DL7AD/seatel/hardware/v1.1/driver.kicad_sch

## KiCad design hardware/v1.1/driver.kicad_sch (2024-06-26)

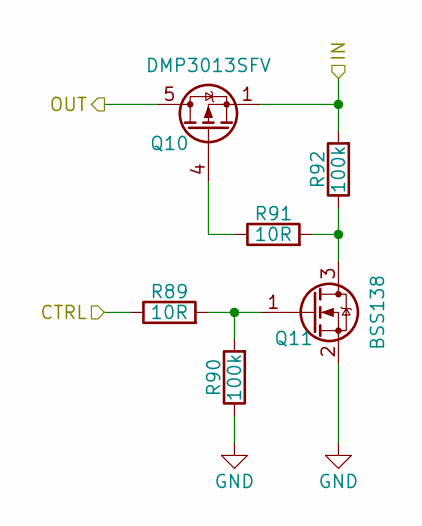
[picture p2: schematic driver.kicad_sch]

Parts:
Q10: DMP3013SFV; Diodes_PowerDI3333-8
Q11: BSS138; SOT-23
R89, R91: 10R; R_0603_1608Metric
R90, R92: 100k; R_0603_1608Metric

Connections:
CTRL: R89.1
GND: Q11.2 (S), R90.1
IN: Q10.1 (S), Q10.2 (S), Q10.3 (S), R92.2
unnamed: Q10.4 (G), R91.1
unnamed: Q11.1 (G), R89.2, R90.2
unnamed: Q11.3 (D), R91.2, R92.1
OUT: Q10.5 (D)
