DL7AD/seatel/hardware/v1.1/seatel.kicad_sch

## KiCad design hardware/v1.1/seatel.kicad_sch (2024-06-26)

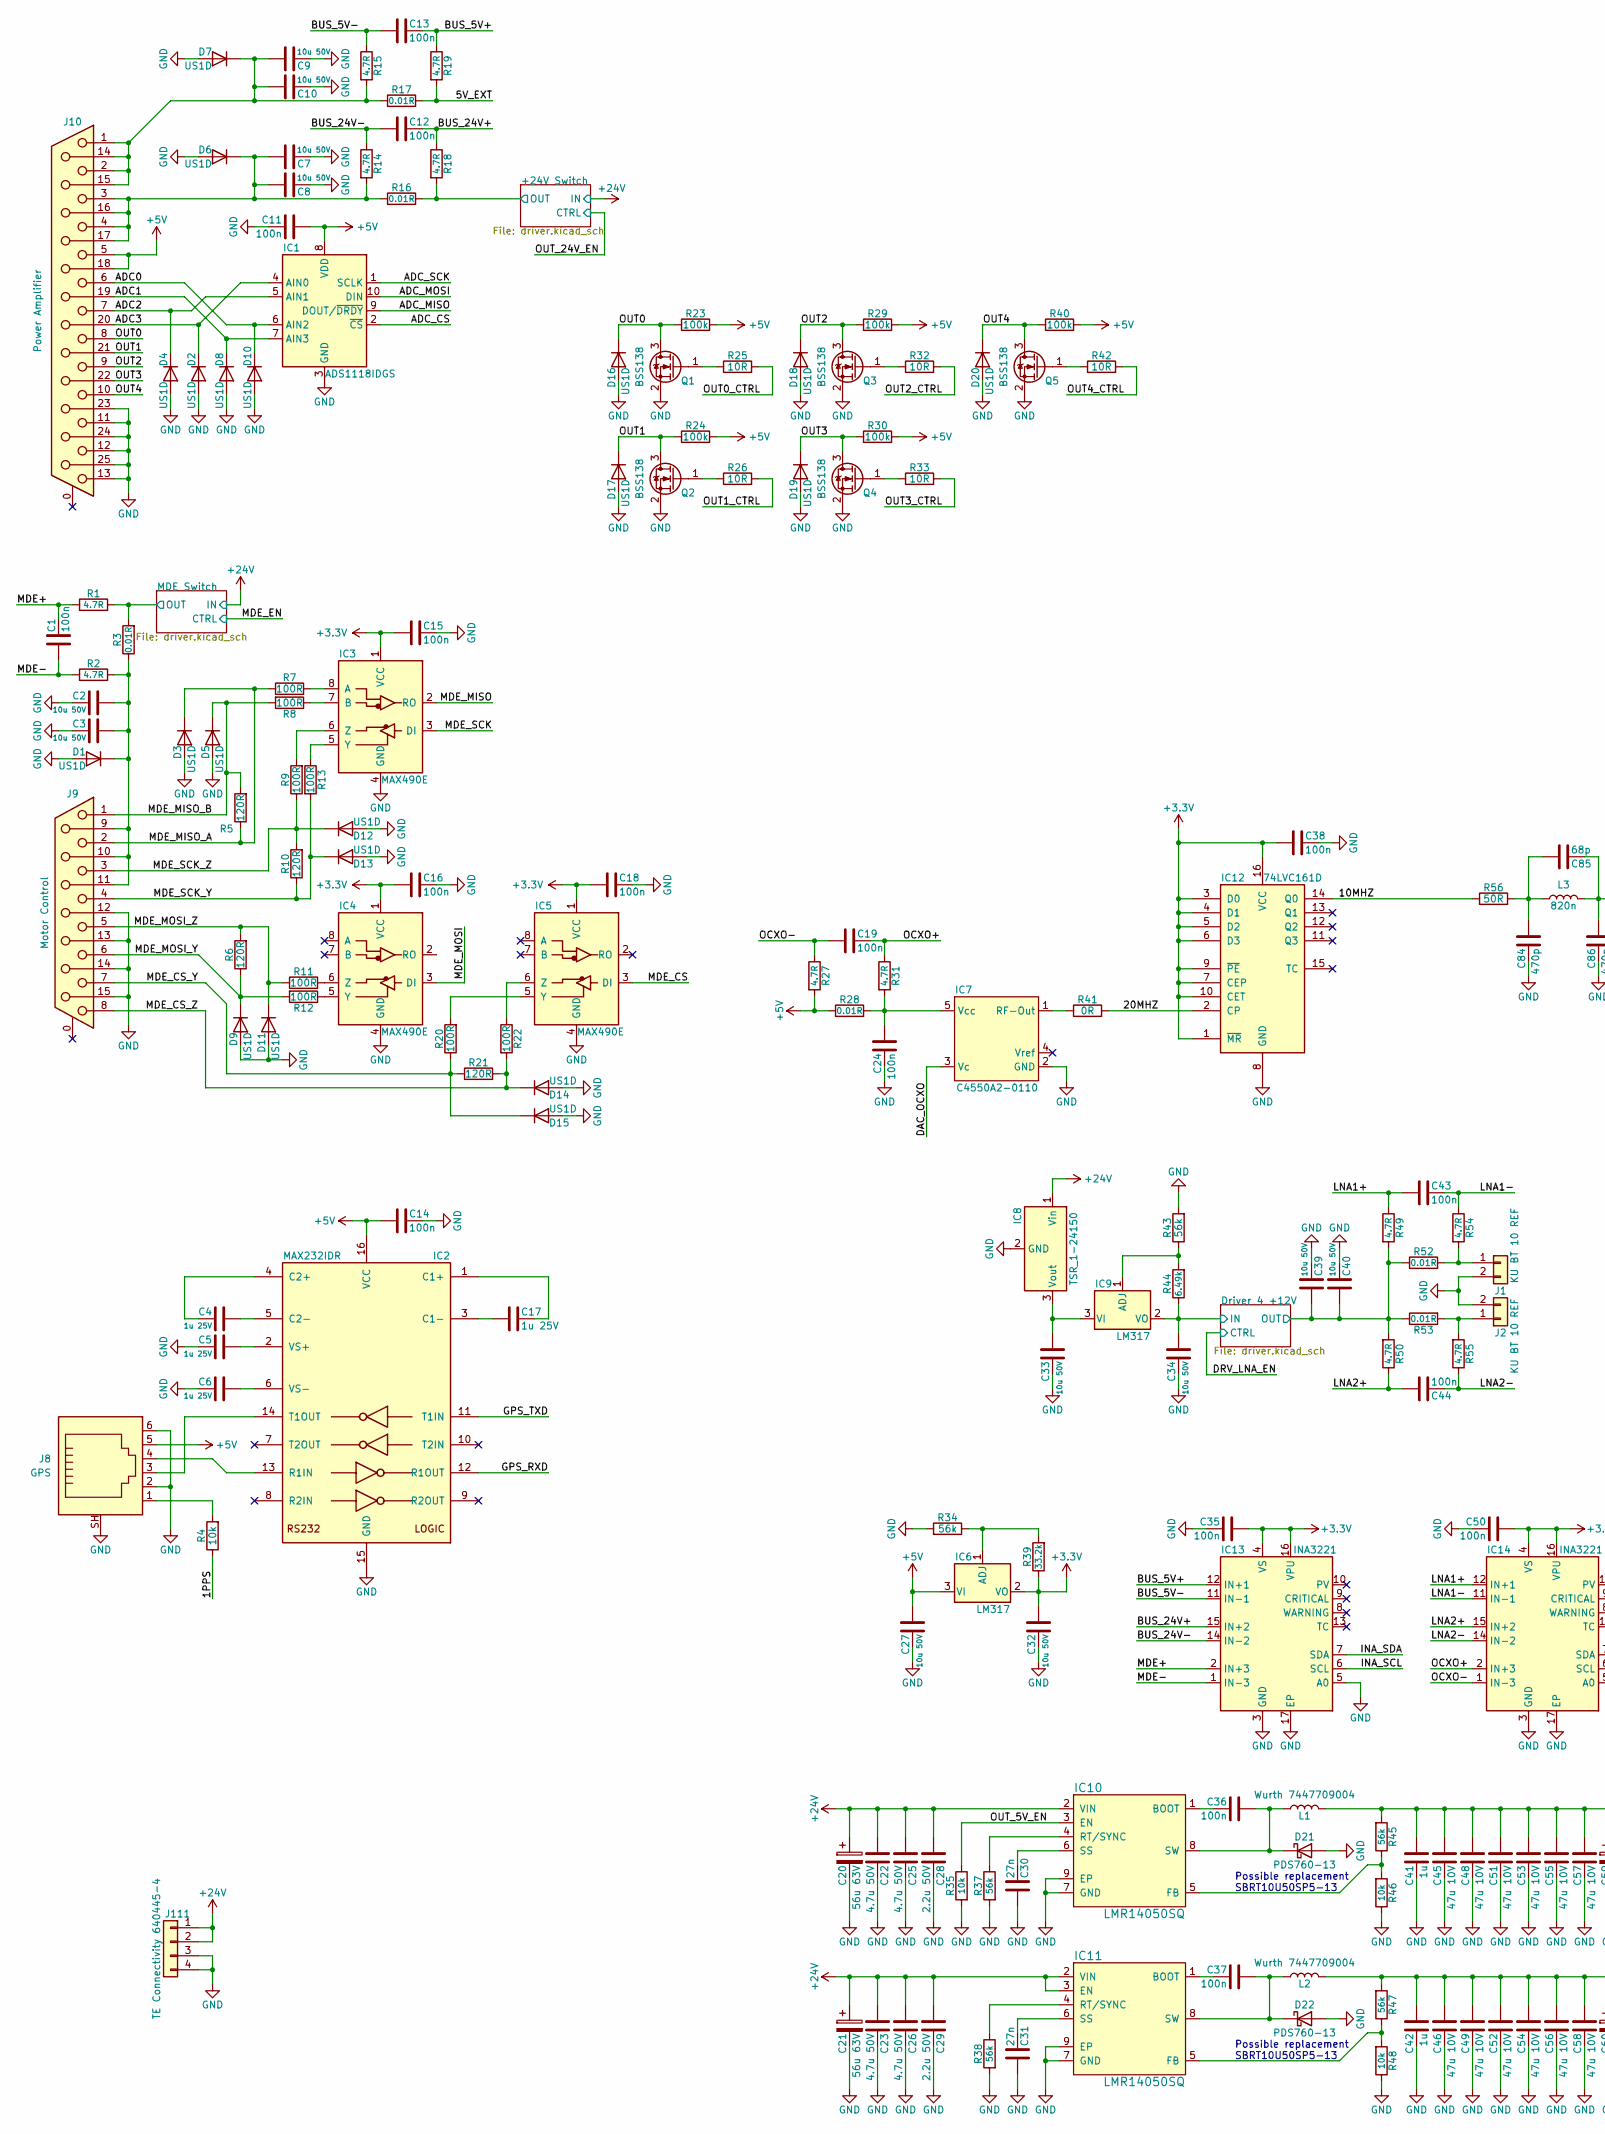
[picture p3: schematic seatel.kicad_sch, part in row 1, column 1]

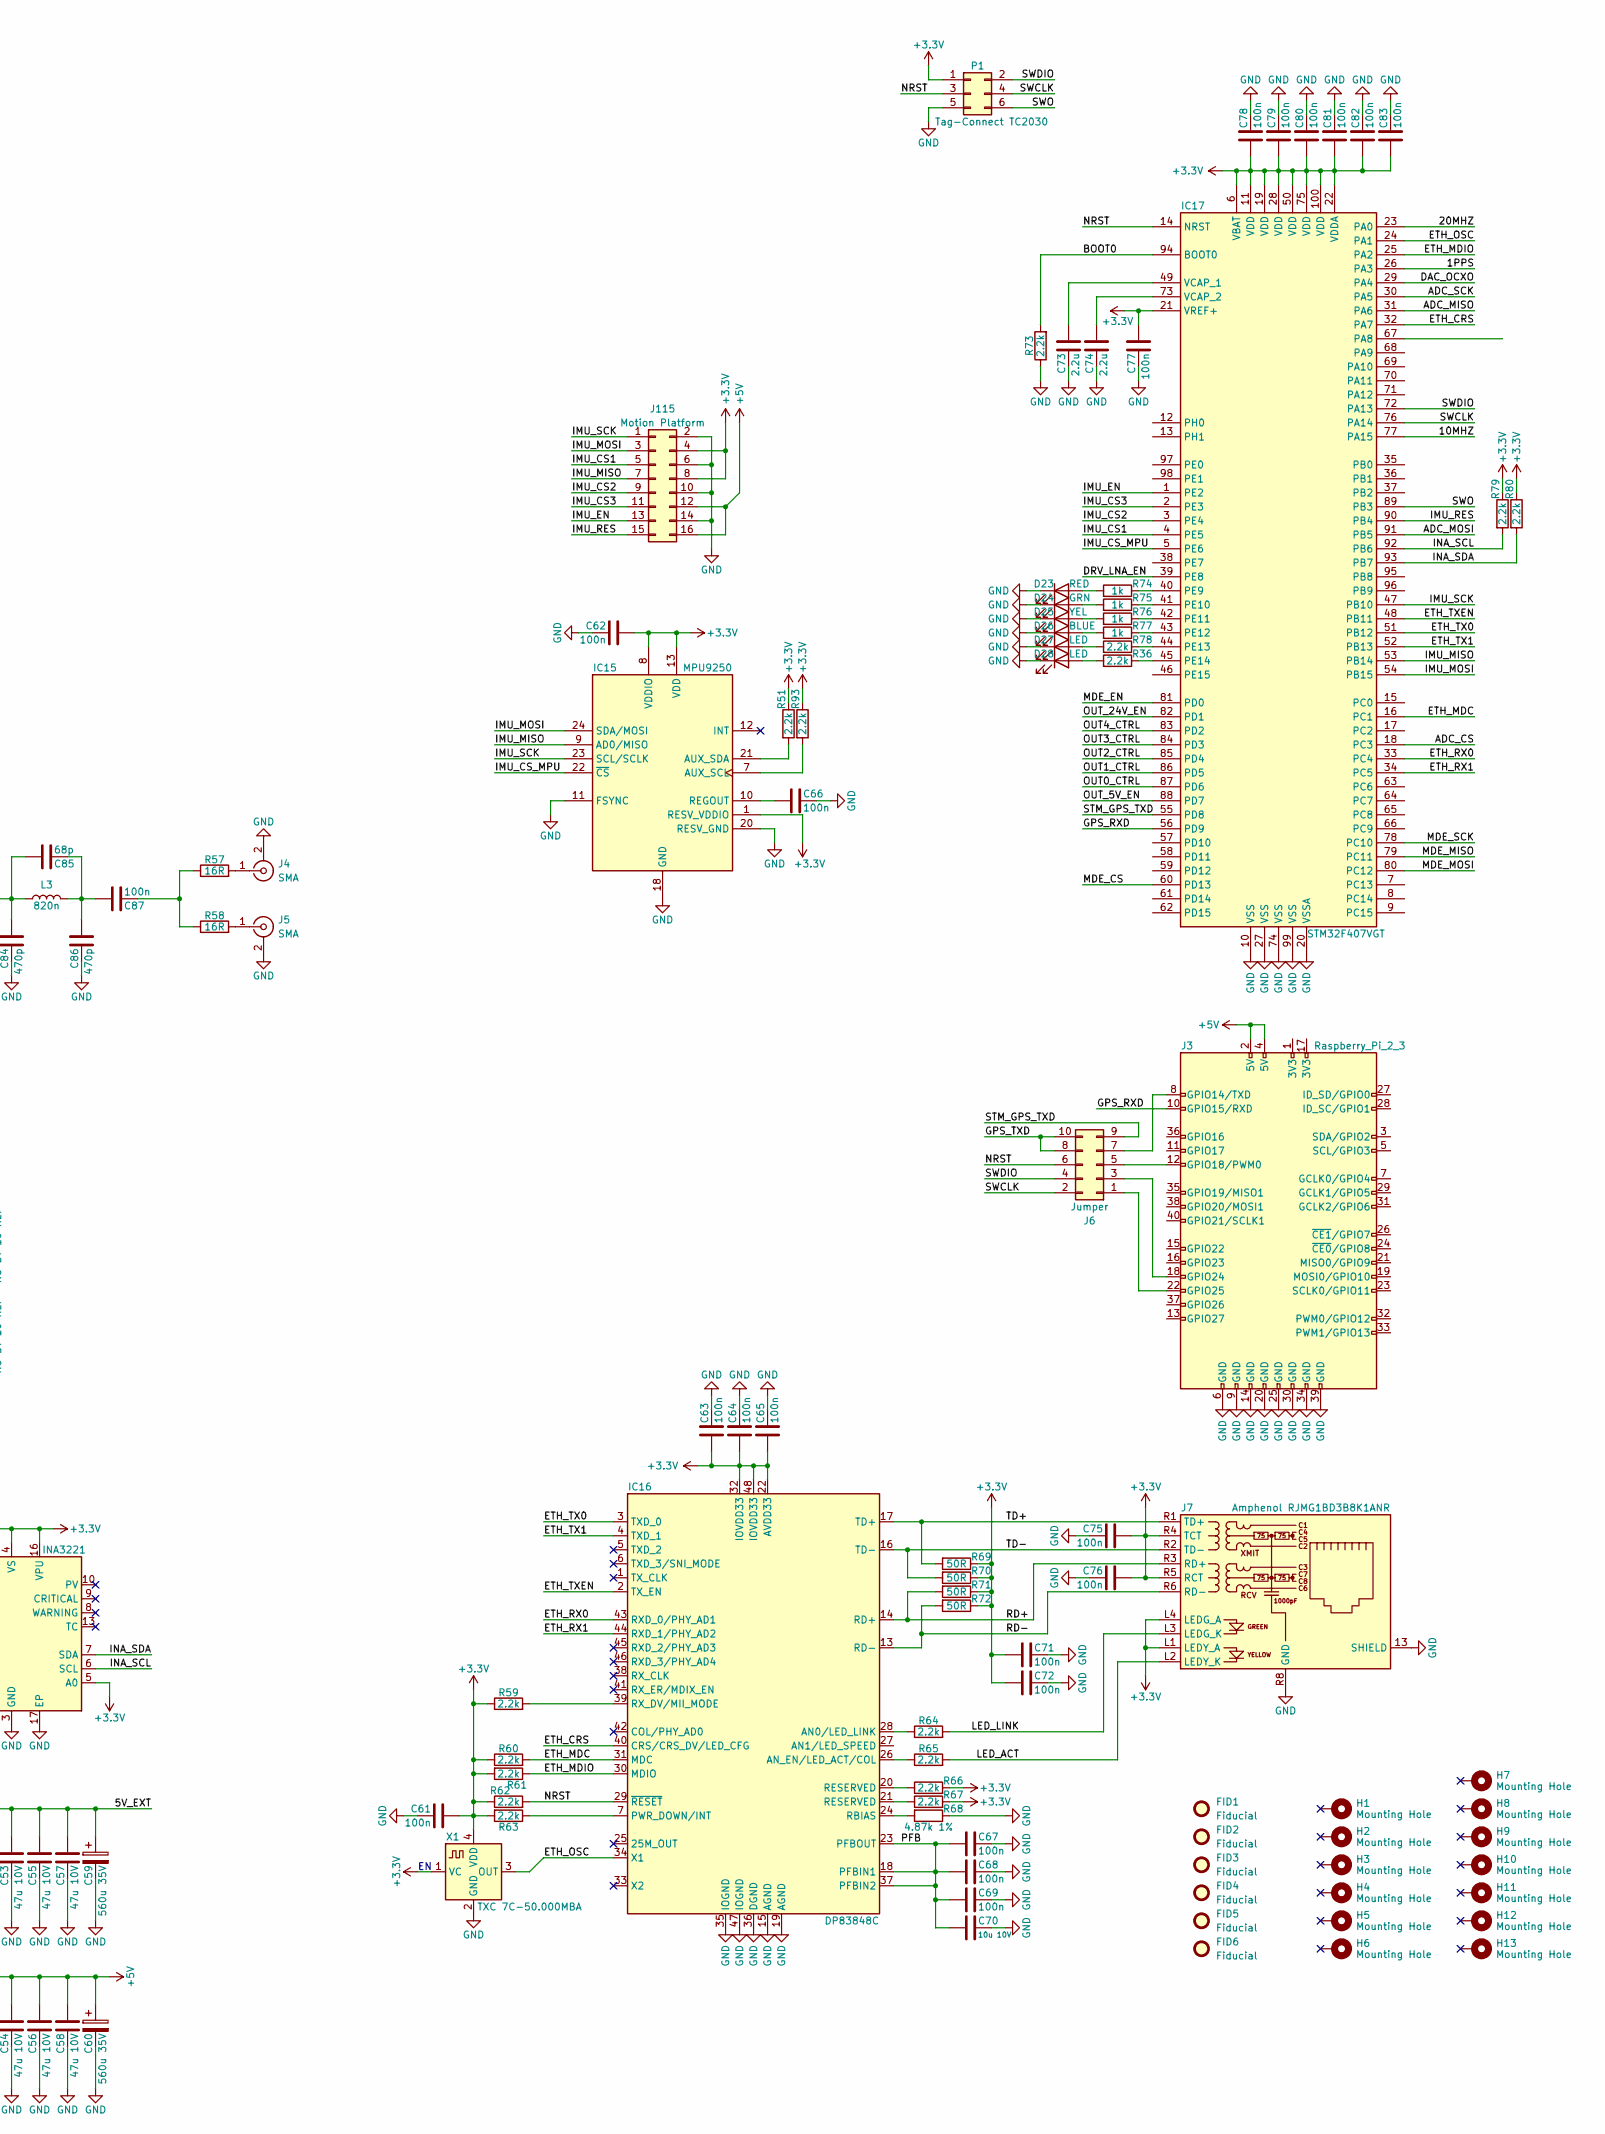
[picture p4: schematic seatel.kicad_sch, part in row 1, column 2]

Parts:
C1, C11, C12, C13, C14, C15, C16, C18, C19, C24, C35, C36, C37, C38, C43, C44, C50, C61, C62, C63, C64, C65, C66, C67, C68, C69, C71, C72, C75, C76, C77, C78, C79, C80, C81, C82, C83, C87: 100n; C_0603_1608Metric
C2, C3, C7, C8, C9, C10, C27, C32, C33, C34, C39, C40: 10u 50V; C_1206_3216Metric
C4, C5, C6, C17: 1u 25V; C_0805_2012Metric
C20, C21: 56u 63V; CP_Elec_10x10
C22, C23, C25, C26: 4.7u 50V; C_1206_3216Metric
C28, C29: 2.2u 50V; C_1206_3216Metric
C30, C31: 27n; C_0603_1608Metric
C41, C42: 1u; C_0805_2012Metric
C45, C46, C48, C49, C51, C52, C53, C54, C55, C56, C57, C58: 47u 10V; C_1206_3216Metric
C59, C60: 560u 35V; CP_Elec_10x10
C70: 10u 10V; C_0805_2012Metric
C73, C74: 2.2u; C_0603_1608Metric
C84, C86: 470p; C_0603_1608Metric
C85: 68p; C_0603_1608Metric
D1, D2, D3, D4, D5, D6, D7, D8, D9, D10, D11, D12, D13, D14, D15, D16, D17, D18, D19, D20: US1D; D_SMA
D21, D22: PDS760-13; POWERDI5
D23: RED; LED_0603_1608Metric
D24: GRN; LED_0603_1608Metric
D25: YEL; LED_0603_1608Metric
D26: BLUE; LED_0603_1608Metric
D27, D28: LED; LED_0603_1608Metric
FID1, FID2, FID3, FID4, FID5, FID6: Fiducial; MountingHole_2.5mm
H1, H2, H3, H4, H5, H6, H7, H8, H9, H10, H11, H12, H13: Mounting Hole; MountingHole_3.5mm_Pad
IC1: ADS1118IDGS; VSSOP-10_3x3mm_P0.5mm
IC2: MAX232IDR; SOIC-16_3.9x9.9mm_P1.27mm
IC3, IC4, IC5: MAX490E; SO-8_3.9x4.9mm_P1.27mm
IC6, IC9: LM317; SOT-223-3_TabPin2
IC7: C4550A2-0110; C4550A2
IC8: TSR_1-24150; Converter_DCDC_TRACO_TSR-1_THT
IC10, IC11: LMR14050SQ; SOIC-8-1EP_3.9x4.9mm_P1.27mm_EP2.514x3.2mm_ThermalVias
IC12: 74LVC161D; SO-16_3.9x9.9mm_P1.27mm
IC13, IC14: INA3221; Texas_RGV_S-PVQFN-N16_EP2.1x2.1mm
IC15: MPU9250; InvenSense_QFN-24_3x3mm_P0.4mm
IC16: DP83848C; LQFP-48_7x7mm_P0.5mm
IC17: STM32F407VGT; LQFP-100_14x14mm_P0.5mm
J1, J2: KU BT 10 REF; KU_BT_10_REF
J3: Raspberry_Pi_2_3; raspberrypi_2_3
J4, J5: SMA; SMA_Amphenol_132291_Vertical
J6: Jumper; PinHeader_2x05_P2.54mm_Horizontal
J7: Amphenol RJMG1BD3B8K1ANR; RJ45_Amphenol_RJMG1BD3B8K1ANR
J8: GPS; TE_1734723-1
J9: Motor Control; DSUB-15_Female_Horizontal_P2.77x2.84mm_EdgePinOffset7.70mm_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
J10: Power Amplifier; DSUB-25_Female_Horizontal_P2.77x2.84mm_EdgePinOffset7.70mm_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
J111: TE Connectivity 640445-4; JST_VH_B4P-VH_1x04_P3.96mm_Vertical
J115: Motion Platform; IDC-Header_2x08-1MP_P2.54mm_Latch6.5mm_Vertical
L1, L2: Wurth 7447709004; SELF-WE-PD-XXL
L3: 820n; L_0805_2012Metric
P1: Tag-Connect TC2030; Tag-Connect_TC2030-IDC-NL_2x03_P1.27mm_Vertical
Q1, Q2, Q3, Q4, Q5: BSS138; SOT-23
R1, R2, R14, R15, R18, R19, R27, R31, R49, R50, R54, R55: 4.7R; R_0603_1608Metric
R3, R16, R17, R28, R52, R53: 0.01R; R_1206_3216Metric
R4, R35, R46, R48: 10k; R_0603_1608Metric
R5, R6, R10, R21: 120R; R_0603_1608Metric
R7, R8, R9, R11, R12, R13, R20, R22: 100R; R_0603_1608Metric
R23, R24, R29, R30, R40: 100k; R_0603_1608Metric
R25, R26, R32, R33, R42: 10R; R_0603_1608Metric
R34, R37, R38, R43, R45, R47: 56k; R_0603_1608Metric
R36, R51, R59, R60, R61, R62, R63, R64, R65, R66, R67, R73, R78, R79, R80, R93: 2.2k; R_0603_1608Metric
R39: 33.2k; R_0603_1608Metric
R41: 0R; R_0603_1608Metric
R44: 6.49k; R_0603_1608Metric
R56, R69, R70, R71, R72: 50R; R_0603_1608Metric
R57, R58: 16R; R_0603_1608Metric
R68: 4.87k 1%; R_0603_1608Metric
R74, R75, R76, R77: 1k; R_0603_1608Metric
X1: TXC 7C-50.000MBA; Oscillator_SMD_Fox_FT5H_5.0x3.2mm

Connections:
1PPS: IC17.26 (PA3), R4.1
5V_EXT: C41.1, C45.1, C48.1, C51.1, C53.1, C55.1, C57.1, C59.1, L1.2, R17.2, R19.2, R45.2
10MHZ: IC12.14 (Q0), IC17.77 (PA15), R56.1
20MHZ: IC12.2 (CP), IC17.23 (PA0), R41.2
+3.3V: C15.1, C16.1, C18.1, C32.1, C35.1, C38.1, C50.1, C61.1, C62.1, C63.1, C64.1, C65.1, C71.1, C72.1, C75.1, C76.1, C77.1, C78.1, C79.1, C80.1, C81.1, C82.1, C83.1, IC3.1 (VCC), IC4.1 (VCC), IC5.1 (VCC), IC6.2 (VO), IC12.1 (~MR), IC12.3 (D0), IC12.4 (D1), IC12.5 (D2), IC12.6 (D3), IC12.7 (CEP), IC12.9 (~PE), IC12.10 (CET), IC12.16 (VCC), IC13.4 (VS), IC13.16 (VPU), IC14.4 (VS), IC14.5 (A0), IC14.16 (VPU), IC15.1 (RESV_VDDIO), IC15.8 (VDDIO), IC15.13 (VDD), IC16.22 (AVDD33), IC16.32 (IOVDD33), IC16.48 (IOVDD33), IC17.6 (VBAT), IC17.11 (VDD), IC17.19 (VDD), IC17.21 (VREF+), IC17.22 (VDDA), IC17.28 (VDD), IC17.50 (VDD), IC17.75 (VDD), IC17.100 (VDD), J7.L1 (LEDY_A), J7.L4 (LEDG_A), J7.R4 (TCT), J7.R5 (RCT), J115.4, J115.8, P1.1, R39.1, R51.1, R59.1, R60.1, R61.2, R62.1, R63.2, R66.2, R67.2, R69.1, R70.1, R71.1, R72.1, R79.1, R80.1, R93.1, X1.1 (VC), X1.4 (VDD)
+5V: C11.1, C14.1, C27.1, C42.1, C46.1, C49.1, C52.1, C54.1, C56.1, C58.1, C60.1, IC1.8 (VDD), IC2.16 (VCC), IC6.3 (VI), J3.2 (5V), J3.4 (5V), J8.5, J10.5, J10.18, J115.12, J115.16, L2.2, R23.2, R24.2, R27.2, R28.1, R29.2, R30.2, R40.2, R47.2
+24V: C20.1, C21.1, C22.1, C23.1, C25.1, C26.1, C28.1, C29.1, IC8.1 (Vin), IC10.2 (VIN), IC11.2 (VIN), IC11.3 (EN), J111.1, J111.2
ADC0: D10.1 (K), IC1.6 (AIN2), J10.6
ADC1: D8.1 (K), IC1.7 (AIN3), J10.19
ADC2: D4.1 (K), IC1.5 (AIN1), J10.7
ADC3: D2.1 (K), IC1.4 (AIN0), J10.20
ADC_CS: IC1.2 (~CS), IC17.18 (PC3)
ADC_MISO: IC1.9 (DOUT/~DRDY), IC17.31 (PA6)
ADC_MOSI: IC1.10 (DIN), IC17.91 (PB5)
ADC_SCK: IC1.1 (SCLK), IC17.30 (PA5)
BOOT0: IC17.94 (BOOT0), R73.2
BUS_5V+: C13.2, IC13.12 (IN+1), R19.1
BUS_5V-: C13.1, IC13.11 (IN-1), R15.1
BUS_24V+: C12.2, IC13.15 (IN+2), R18.1
BUS_24V-: C12.1, IC13.14 (IN-2), R14.1
DAC_OCXO: IC7.3 (Vc), IC17.29 (PA4)
DRV_LNA_EN: IC17.39 (PE8)
ETH_CRS: IC16.40 (CRS/CRS_DV/LED_CFG), IC17.32 (PA7)
ETH_MDC: IC16.31 (MDC), IC17.16 (PC1), R60.2
ETH_MDIO: IC16.30 (MDIO), IC17.25 (PA2), R61.1
ETH_OSC: IC16.34 (X1), IC17.24 (PA1), X1.3 (OUT)
ETH_RX0: IC16.43 (RXD_0/PHY_AD1), IC17.33 (PC4)
ETH_RX1: IC16.44 (RXD_1/PHY_AD2), IC17.34 (PC5)
ETH_TX0: IC16.3 (TXD_0), IC17.51 (PB12)
ETH_TX1: IC16.4 (TXD_1), IC17.52 (PB13)
ETH_TXEN: IC16.2 (TX_EN), IC17.48 (PB11)
GND: C2.2, C3.2, C5.2, C6.2, C7.2, C8.2, C9.2, C10.2, C11.2, C14.2, C15.2, C16.2, C18.2, C20.2, C21.2, C22.2, C23.2, C24.2, C25.2, C26.2, C27.2, C28.2, C29.2, C30.1, C31.1, C32.2, C33.2, C34.2, C35.2, C38.2, C39.2, C40.2, C41.2, C42.2, C45.2, C46.2, C48.2, C49.2, C50.2, C51.2, C52.2, C53.2, C54.2, C55.2, C56.2, C57.2, C58.2, C59.2, C60.2, C61.2, C62.2, C63.2, C64.2, C65.2, C66.2, C67.2, C68.2, C69.2, C70.2, C71.2, C72.2, C73.2, C74.2, C75.2, C76.2, C77.2, C78.2, C79.2, C80.2, C81.2, C82.2, C83.2, C84.2, C86.2, D1.2 (A), D2.2 (A), D3.2 (A), D4.2 (A), D5.2 (A), D6.2 (A), D7.2 (A), D8.2 (A), D9.2 (A), D10.2 (A), D11.2 (A), D12.2 (A), D13.2 (A), D14.2 (A), D15.2 (A), D16.2 (A), D17.2 (A), D18.2 (A), D19.2 (A), D20.2 (A), D21.2 (A), D22.2 (A), D23.1 (K), D24.1 (K), D25.1 (K), D26.1 (K), D27.1 (K), D28.1 (K), IC1.3 (GND), IC2.15 (GND), IC3.4 (GND), IC4.4 (GND), IC5.4 (GND), IC7.2 (GND), IC8.2 (GND), IC10.7 (GND), IC10.9 (EP), IC11.7 (GND), IC11.9 (EP), IC12.8 (GND), IC13.3 (GND), IC13.5 (A0), IC13.17 (EP), IC14.3 (GND), IC14.17 (EP), IC15.11 (FSYNC), IC15.18 (GND), IC15.20 (RESV_GND), IC16.15 (AGND), IC16.19 (AGND), IC16.35 (IOGND), IC16.36 (DGND), IC16.47 (IOGND), IC17.10 (VSS), IC17.20 (VSSA), IC17.27 (VSS), IC17.74 (VSS), IC17.99 (VSS), J1.2, J2.2, J3.6 (GND), J3.9 (GND), J3.14 (GND), J3.20 (GND), J3.25 (GND), J3.30 (GND), J3.34 (GND), J3.39 (GND), J4.2 (Ext), J5.2 (Ext), J7.13 (SHIELD), J7.R8 (GND), J8.2, J8.6, J8.SH, J9.12, J9.13, J9.14, J9.15, J10.11, J10.12, J10.13, J10.23, J10.24, J10.25, J111.3, J111.4, J115.2, J115.6, J115.10, J115.14, P1.5, Q1.2 (S), Q2.2 (S), Q3.2 (S), Q4.2 (S), Q5.2 (S), R34.2, R35.2, R37.2, R38.2, R43.2, R46.1, R48.1, R68.1, R73.1, X1.2 (GND)
GPS_RXD: IC2.12 (R1OUT), IC17.56 (PD9), J3.10 (GPIO15/RXD)
GPS_TXD: IC2.11 (T1IN), J6.8, J6.10
IMU_CS1: IC17.4 (PE5), J115.5
IMU_CS2: IC17.3 (PE4), J115.9
IMU_CS3: IC17.2 (PE3), J115.11
IMU_CS_MPU: IC15.22 (~CS), IC17.5 (PE6)
IMU_EN: IC17.1 (PE2), J115.13
IMU_MISO: IC15.9 (AD0/MISO), IC17.53 (PB14), J115.7
IMU_MOSI: IC15.24 (SDA/MOSI), IC17.54 (PB15), J115.3
IMU_RES: IC17.90 (PB4), J115.15
IMU_SCK: IC15.23 (SCL/SCLK), IC17.47 (PB10), J115.1
IN: C34.1, IC9.2 (VO), R44.1
INA_SCL: IC13.6 (SCL), IC14.6 (SCL), IC17.92 (PB6), R79.2
INA_SDA: IC13.7 (SDA), IC14.7 (SDA), IC17.93 (PB7), R80.2
LED_ACT: J7.L2 (LEDY_K), R65.2
LED_LINK: J7.L3 (LEDG_K), R64.2
LNA1+: C43.1, IC14.12 (IN+1), R49.1
LNA1-: C43.2, IC14.11 (IN-1), R54.1
LNA2+: C44.1, IC14.15 (IN+2), R50.1
LNA2-: C44.2, IC14.14 (IN-2), R55.1
MDE+: C1.2, IC13.2 (IN+3), R1.1
MDE-: C1.1, IC13.1 (IN-3), R2.1
MDE_CS: IC5.3 (DI), IC17.60 (PD13)
MDE_CS_Y: D15.1 (K), J9.7, R20.1, R21.1
MDE_CS_Z: D14.1 (K), J9.8, R21.2, R22.2
MDE_EN: IC17.81 (PD0)
MDE_MISO: IC3.2 (RO), IC17.79 (PC11)
MDE_MISO_A: D3.1 (K), J9.2, R5.1, R7.1
MDE_MISO_B: D5.1 (K), J9.1, R5.2, R8.2
MDE_MOSI: IC4.3 (DI), IC17.80 (PC12)
MDE_MOSI_Y: D9.1 (K), J9.6, R6.1, R12.2
MDE_MOSI_Z: D11.1 (K), J9.5, R6.2, R11.1
MDE_SCK: IC3.3 (DI), IC17.78 (PC10)
MDE_SCK_Y: D13.1 (K), J9.4, R10.1, R13.2
MDE_SCK_Z: D12.1 (K), J9.3, R9.1, R10.2
NRST: IC16.29 (~RESET), IC17.14 (NRST), J6.6, P1.3, R62.2
unnamed: C2.1, C3.1, D1.1 (K), J9.9, J9.10, J9.11 (P111), R2.2, R3.1
unnamed: C4.1, IC2.5 (C2-)
unnamed: C4.2, IC2.4 (C2+)
unnamed: C5.1, IC2.2 (VS+)
unnamed: C6.1, IC2.6 (VS-)
unnamed: C7.1, C8.1, D6.1 (K), J10.3, J10.4, J10.16, J10.17, R14.2, R16.1
unnamed: C9.1, C10.1, D7.1 (K), J10.1, J10.2, J10.14, J10.15, R15.2, R17.1
unnamed: C17.1, IC2.3 (C1-)
unnamed: C17.2, IC2.1 (C1+)
unnamed: C24.1, IC7.5 (Vcc), R28.2, R31.2
unnamed: C30.2, IC10.6 (SS)
unnamed: C31.2, IC11.6 (SS)
unnamed: C33.1, IC8.3 (Vout), IC9.3 (VI)
unnamed: C36.1, D21.1 (K), IC10.8 (SW), L1.1
unnamed: C36.2, IC10.1 (BOOT)
unnamed: C37.1, D22.1 (K), IC11.8 (SW), L2.1
unnamed: C37.2, IC11.1 (BOOT)
unnamed: C66.1, IC15.10 (REGOUT)
unnamed: C73.1, IC17.49 (VCAP_1)
unnamed: C74.1, IC17.73 (VCAP_2)
unnamed: C84.1, C85.1, L3.1, R56.2
unnamed: C85.2, C86.1, C87.1, L3.2
unnamed: C87.2, R57.1, R58.1
unnamed: D23.2 (A), R74.2
unnamed: D24.2 (A), R75.2
unnamed: D25.2 (A), R76.2
unnamed: D26.2 (A), R77.2
unnamed: D27.2 (A), R78.2
unnamed: D28.2 (A), R36.2
unnamed: IC2.13 (R1IN), J8.4
unnamed: IC2.14 (T1OUT), J8.3
unnamed: IC3.5 (Y), R13.1
unnamed: IC3.6 (Z), R9.2
unnamed: IC3.7 (B), R8.1
unnamed: IC3.8 (A), R7.2
unnamed: IC4.5 (Y), R12.1
unnamed: IC4.6 (Z), R11.2
unnamed: IC5.5 (Y), R20.2
unnamed: IC5.6 (Z), R22.1
unnamed: IC6.1 (ADJ), R34.1, R39.2
unnamed: IC7.1 (RF-Out), R41.1
unnamed: IC9.1 (ADJ), R43.1, R44.2
unnamed: IC10.4 (RT/SYNC), R37.1
unnamed: IC10.5 (FB), R45.1, R46.2
unnamed: IC11.4 (RT/SYNC), R38.1
unnamed: IC11.5 (FB), R47.1, R48.2
unnamed: IC15.7 (AUX_SCL), R93.2
unnamed: IC15.21 (AUX_SDA), R51.2
unnamed: IC16.7 (PWR_DOWN/INT), R63.1
unnamed: IC16.20 (RESERVED), R66.1
unnamed: IC16.21 (RESERVED), R67.1
unnamed: IC16.24 (RBIAS), R68.2
unnamed: IC16.26 (AN_EN/LED_ACT/COL), R65.1
unnamed: IC16.28 (AN0/LED_LINK), R64.1
unnamed: IC16.39 (RX_DV/MII_MODE), R59.2
unnamed: IC17.40 (PE9), R74.1
unnamed: IC17.41 (PE10), R75.1
unnamed: IC17.42 (PE11), R76.1
unnamed: IC17.43 (PE12), R77.1
unnamed: IC17.44 (PE13), R78.1
unnamed: IC17.45 (PE14), R36.1
unnamed: J1.1, R52.2, R54.2
unnamed: J2.1, R53.2, R55.2
unnamed: J3.8 (GPIO14/TXD), J6.7
unnamed: J3.12 (GPIO18/PWM0), J6.5
unnamed: J3.18 (GPIO24), J6.3
unnamed: J3.22 (GPIO25), J6.1
unnamed: J4.1 (In), R57.2
unnamed: J5.1 (In), R58.2
unnamed: J8.1, R4.2
unnamed: Q1.1 (G), R25.1
unnamed: Q2.1 (G), R26.1
unnamed: Q3.1 (G), R32.1
unnamed: Q4.1 (G), R33.1
unnamed: Q5.1 (G), R42.1
OCXO+: C19.2, IC14.2 (IN+3), R31.1
OCXO-: C19.1, IC14.1 (IN-3), R27.1
OUT: C39.1, C40.1, R1.2, R3.2, R16.2, R18.2, R49.2, R50.2, R52.1, R53.1
OUT0: D16.1 (K), J10.8, Q1.3 (D), R23.1
OUT0_CTRL: IC17.87 (PD6), R25.2
OUT1: D17.1 (K), J10.21, Q2.3 (D), R24.1
OUT1_CTRL: IC17.86 (PD5), R26.2
OUT2: D18.1 (K), J10.9, Q3.3 (D), R29.1
OUT2_CTRL: IC17.85 (PD4), R32.2
OUT3: D19.1 (K), J10.22, Q4.3 (D), R30.1
OUT3_CTRL: IC17.84 (PD3), R33.2
OUT4: D20.1 (K), J10.10, Q5.3 (D), R40.1
OUT4_CTRL: IC17.83 (PD2), R42.2
OUT_5V_EN: IC10.3 (EN), IC17.88 (PD7), R35.1
OUT_24V_EN: IC17.82 (PD1)
PFB: C67.1, C68.1, C69.1, C70.1, IC16.18 (PFBIN1), IC16.23 (PFBOUT), IC16.37 (PFBIN2)
RD+: IC16.14 (RD+), J7.R3 (RD+), R71.2
RD-: IC16.13 (RD-), J7.R6 (RD-), R72.2
STM_GPS_TXD: IC17.55 (PD8), J6.9
SWCLK: IC17.76 (PA14), J6.2, P1.4
SWDIO: IC17.72 (PA13), J6.4, P1.2
SWO: IC17.89 (PB3), P1.6
TD+: IC16.17 (TD+), J7.R1 (TD+), R69.2
TD-: IC16.16 (TD-), J7.R2 (TD-), R70.2

Notes on the sheet:
Possible replacement SBRT10U50SP5-13
