DL7AD/seatel/software/favicon.c

#include "favicon.h"

const char favicon[] = {
  0x89, 0x50, 0x4e, 0x47, 0x0d, 0x0a, 0x1a, 0x0a, 0x00, 0x00, 0x00, 0x0d, 0x49, 0x48, 0x44, 0x52, 
  0x00, 0x00, 0x00, 0x20, 0x00, 0x00, 0x00, 0x20, 0x08, 0x06, 0x00, 0x00, 0x00, 0x73, 0x7a, 0x7a, 
  0xf4, 0x00, 0x00, 0x01, 0x84, 0x69, 0x43, 0x43, 0x50, 0x49, 0x43, 0x43, 0x20, 0x70, 0x72, 0x6f, 
  0x66, 0x69, 0x6c, 0x65, 0x00, 0x00, 0x28, 0x91, 0x7d, 0x91, 0x3d, 0x48, 0xc3, 0x40, 0x1c, 0xc5, 
  0x5f, 0x5b, 0x4b, 0x8b, 0x54, 0x3a, 0xd8, 0x41, 0xc4, 0x21, 0x43, 0x75, 0xd1, 0x82, 0xa8, 0x88, 
  0xa3, 0x56, 0xa1, 0x08, 0x15, 0x42, 0xad, 0xd0, 0xaa, 0x83, 0xc9, 0xa5, 0x5f, 0xd0, 0xa4, 0x21, 
  0x49, 0x71, 0x71, 0x14, 0x5c, 0x0b, 0x0e, 0x7e, 0x2c, 0x56, 0x1d, 0x5c, 0x9c, 0x75, 0x75, 0x70, 
  0x15, 0x04, 0xc1, 0x0f, 0x10, 0x57, 0x17, 0x27, 0x45, 0x17, 0x29, 0xf1, 0x7f, 0x49, 0xa1, 0x45, 
  0x8c, 0x07, 0xc7, 0xfd, 0x78, 0x77, 0xef, 0x71, 0xf7, 0x0e, 0xf0, 0x37, 0xab, 0x4c, 0x35, 0x7b, 
  0xc6, 0x01, 0x55, 0xb3, 0x8c, 0x4c, 0x2a, 0x29, 0xe4, 0xf2, 0xab, 0x42, 0xe8, 0x15, 0x61, 0x04, 
  0x01, 0x8c, 0x22, 0x2a, 0x31, 0x53, 0x9f, 0x13, 0xc5, 0x34, 0x3c, 0xc7, 0xd7, 0x3d, 0x7c, 0x7c, 
  0xbd, 0x4b, 0xf0, 0x2c, 0xef, 0x73, 0x7f, 0x8e, 0x3e, 0xa5, 0x60, 0x32, 0xc0, 0x27, 0x10, 0xcf, 
  0x32, 0xdd, 0xb0, 0x88, 0x37, 0x88, 0xa7, 0x37, 0x2d, 0x9d, 0xf3, 0x3e, 0x71, 0x8c, 0x95, 0x25, 
  0x85, 0xf8, 0x9c, 0x78, 0xcc, 0xa0, 0x0b, 0x12, 0x3f, 0x72, 0x5d, 0x76, 0xf9, 0x8d, 0x73, 0xc9, 
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
  0x04, 0xc9, 0x0f, 0x27, 0xb4, 0x75, 0x5a, 0x64, 0x8a, 0x03, 0xb5, 0xe3, 0x68, 0xa1, 0x0e, 0x85, 
  0x46, 0xf9, 0xd5, 0x34, 0x64, 0x37, 0xfb, 0xf6, 0xc7, 0x7b, 0xf7, 0x9e, 0xfe, 0x91, 0x2c, 0x09, 
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
};

const size_t favicon_size = sizeof(favicon);
