DL7AD/seatel/(commit log)

2024-06-26 Added hardware v1.0 and v1.1 and initial software
    [STM32L4+.ods, driver.kicad_sch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]
2024-07-06 Moved hardware files
    [driver.kicad_sch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]
2024-07-06 Changed DMA streams
2024-07-06 Changed Ctrl thread priority, added failsafe on IMU failure, changed holding torque due to now balanced system
    [ctrl.c]
2024-07-06 Added IMU calibration, added code for MPU9250 magnetometer (unfinished)
2024-07-06 Reimplemented INA3221 power measurement sensor
2024-07-06 Added IMU calibration on MDE startup
2024-07-06 Added pulldown to 1PPS pin
2025-06-21 Changed motor control algorithm slightly, fixed regular HTTP server crashes
    [api.c, ctrl.c, http.c, mde.c, mde.h, ocxo.c]
2025-07-03 Added missing offset in graphics, added complete method in ajax request
    [http.c]
2025-07-04 Fixed wrong index handling in loop
    [http.c]
