DL7AD/seatel/(notices)

Notices in the files:
software/lwipopts.h:
Copyright (c) 2001-2004 Swedish Institute of Computer Science.
All rights reserved.
